azouzkm/CO2-Hyperventilation-monitor/docs/photos/README.md

# Bench photos

Named `YYYY-MM-DD_what.jpg`, resized to 1,200 px. The originals (HEIC) stay on the phone; HEIC is
not committed (`.gitignore`).

## 25 Oct 2026, session 3

| Photo | What it shows |
| --- | --- |
| `2026-10-25_coupon.jpg` | The tubing-fit coupon: five barbs, 4.8 to 6.4 mm, marked 1 to 5 dots |
| `2026-10-25_lid_and_coupon.jpg` | Lid and coupon side by side |
| `2026-10-25_flowcell_open_sensor_in_tray.jpg` | The MH-Z19C in the printed tray, cable out through the notch, lid beside it |
| `2026-10-25_flowcell_closed.jpg` | Flow-cell closed: inlet barb (next to the dot) and outlet barb on the lid |
| `2026-10-25_ring_soldered_to_grove_lead.jpg` | NeoPixel Ring 16 soldered to a Grove lead |
| `2026-10-25_shield_top.jpg` | Pico 2 W on the Grove shield, from above |
| `2026-10-25_button_and_speaker_leads.jpg` | Acknowledge button and speaker with their leads, before wiring |
| `2026-10-25_amplifier_front.jpg` | PAM8302A amplifier, front: bare holes, needs soldering |
| `2026-10-25_amplifier_back.jpg` | PAM8302A amplifier, back, with the hole labels |
| `2026-10-25_breadboard_button_and_speaker.jpg` | Button, speaker and resistor on the breadboard (no soldering) |
| `2026-10-25_shield_jumpers_gp18_gp20.jpg` | Jumpers to GP18 (speaker) and GP20 (button) on the shield |
