azouzkm/CO2-Hyperventilation-monitor/docs/photos/2026-10-25_amplifier_back.jpg

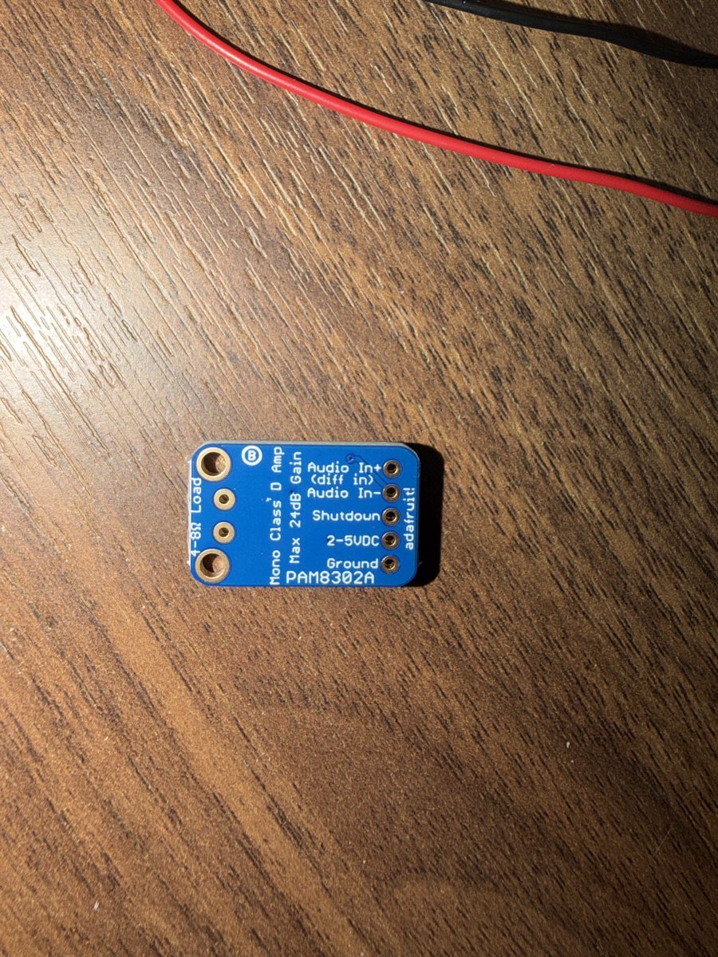
docs/photos/2026-10-25_amplifier_back.jpg
