azouzkm/CO2-Hyperventilation-monitor/docs/photos/2026-10-25_amplifier_front.jpg

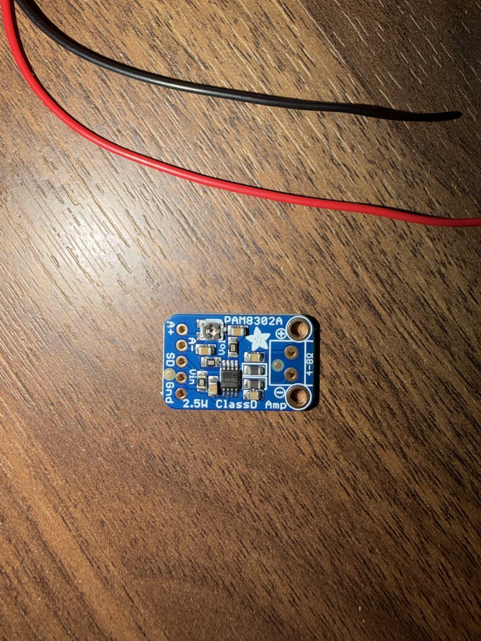
docs/photos/2026-10-25_amplifier_front.jpg
