azouzkm/CO2-Hyperventilation-monitor/docs/photos/2026-10-25_breadboard_button_and_speaker.jpg

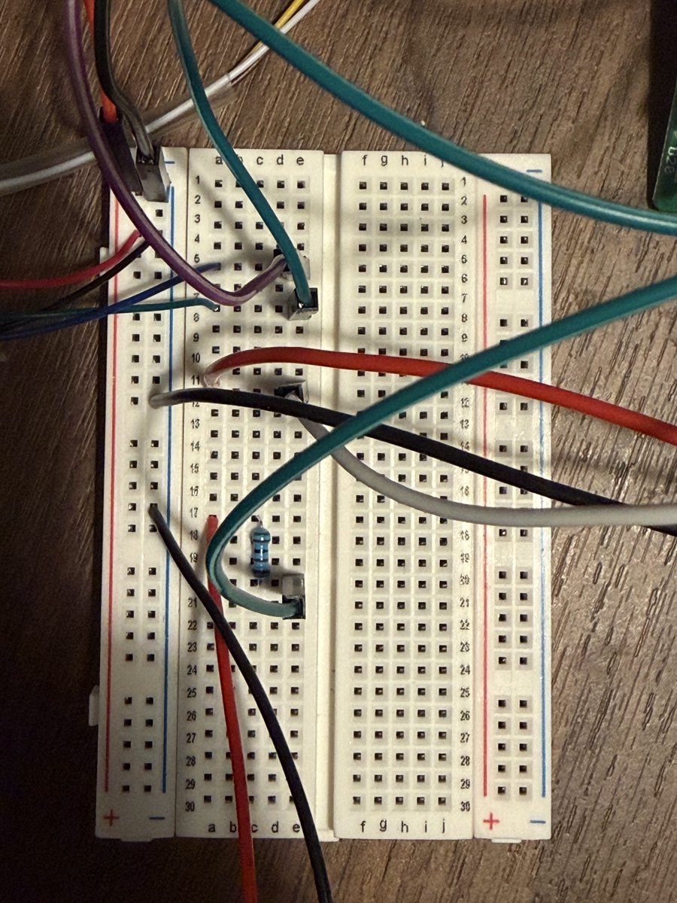
docs/photos/2026-10-25_breadboard_button_and_speaker.jpg
