azouzkm/CO2-Hyperventilation-monitor/docs/photos/2026-10-25_button_and_speaker_leads.jpg

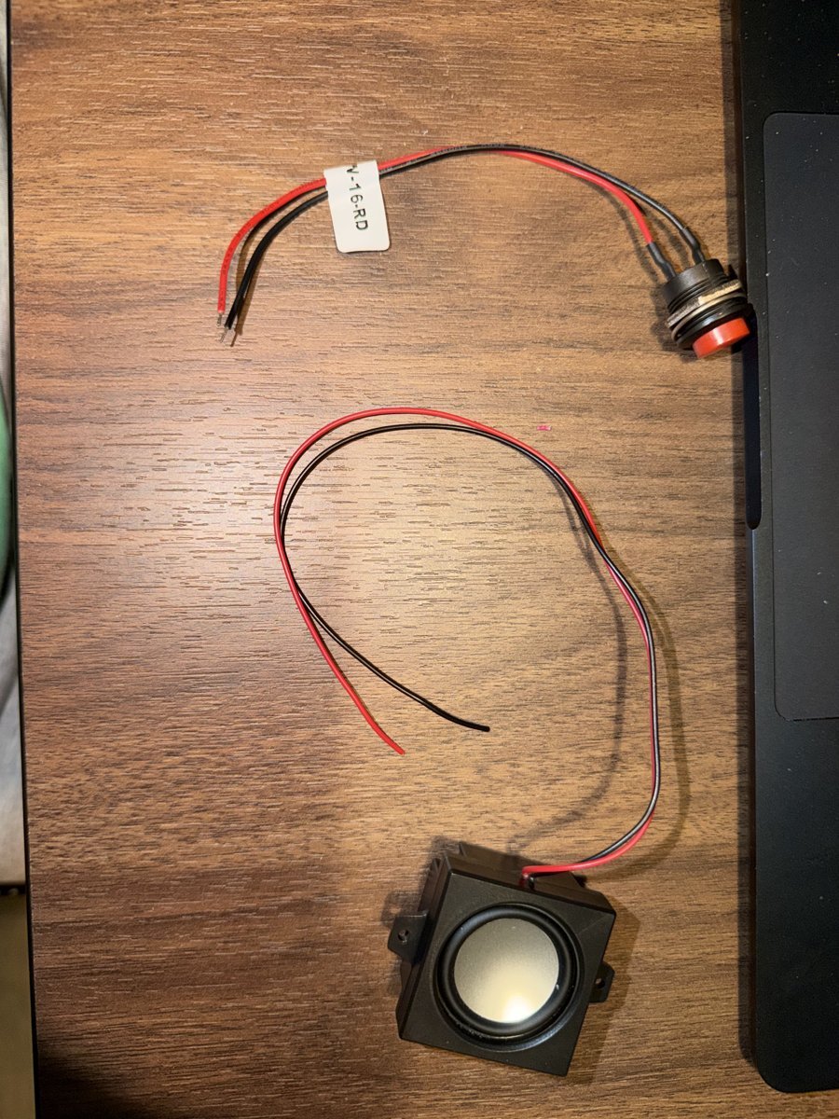
docs/photos/2026-10-25_button_and_speaker_leads.jpg
