azouzkm/CO2-Hyperventilation-monitor/docs/photos/2026-10-25_flowcell_closed.jpg

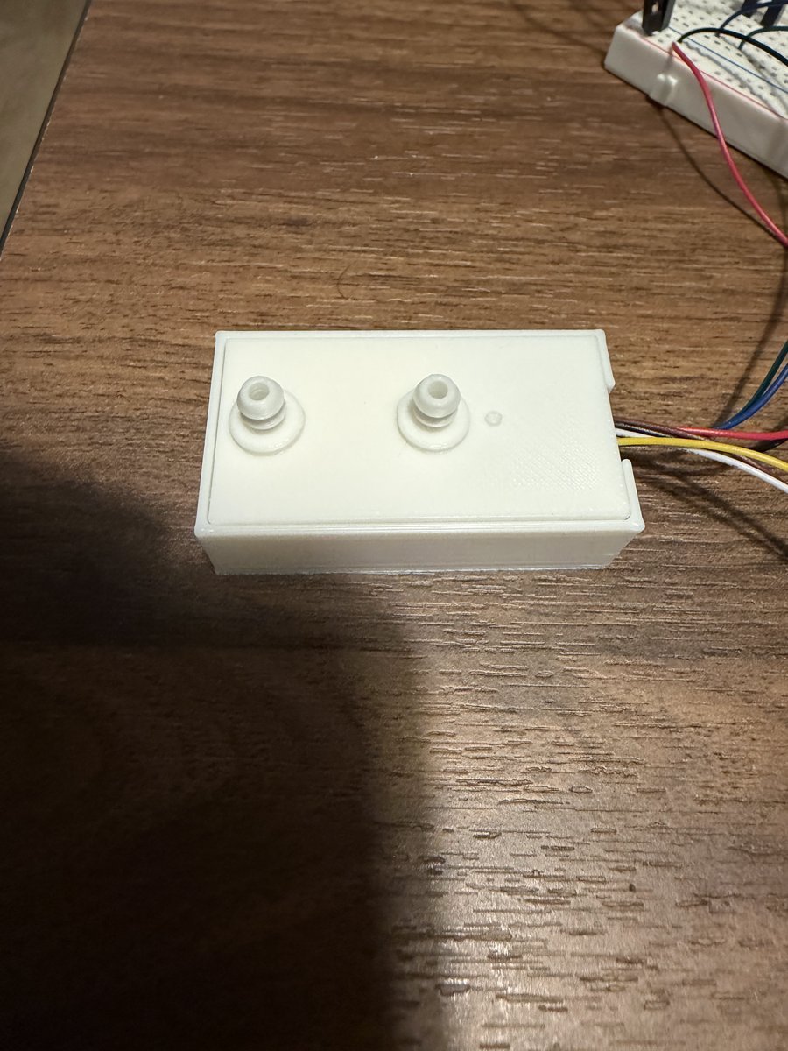
docs/photos/2026-10-25_flowcell_closed.jpg
