azouzkm/CO2-Hyperventilation-monitor/docs/photos/2026-10-25_flowcell_open_sensor_in_tray.jpg

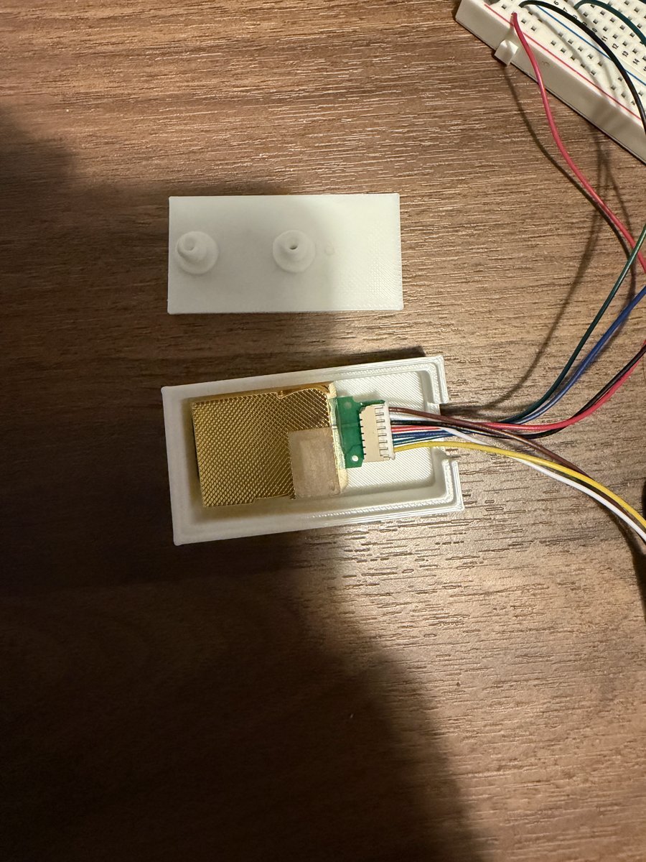
docs/photos/2026-10-25_flowcell_open_sensor_in_tray.jpg
