azouzkm/CO2-Hyperventilation-monitor/docs/photos/2026-10-25_lid_and_coupon.jpg

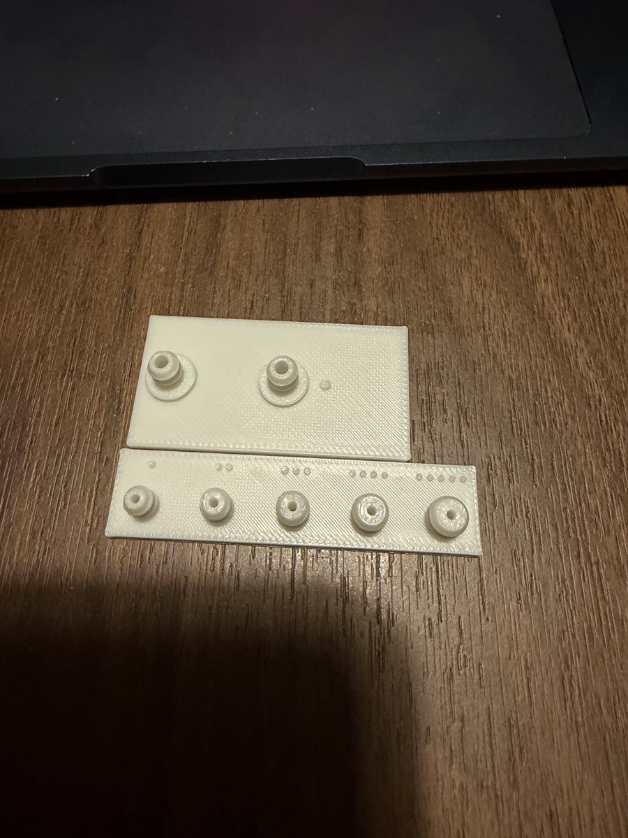
docs/photos/2026-10-25_lid_and_coupon.jpg
