azouzkm/CO2-Hyperventilation-monitor/docs/photos/2026-10-25_shield_jumpers_gp18_gp20.jpg

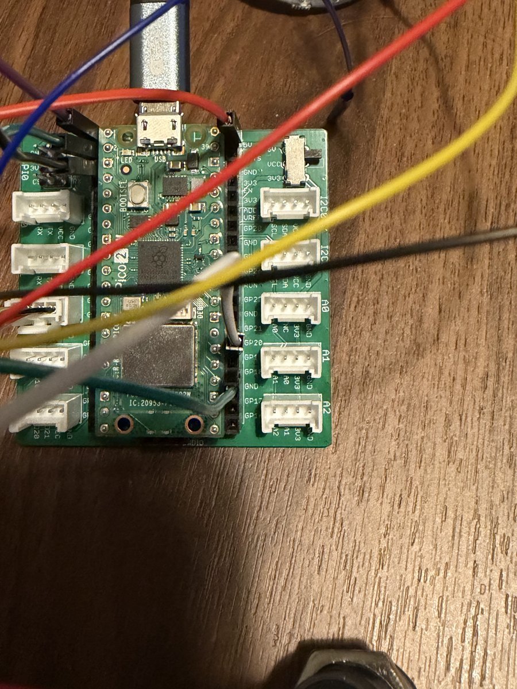
docs/photos/2026-10-25_shield_jumpers_gp18_gp20.jpg
