azouzkm/CO2-Hyperventilation-monitor/docs/photos/2026-10-25_shield_top.jpg

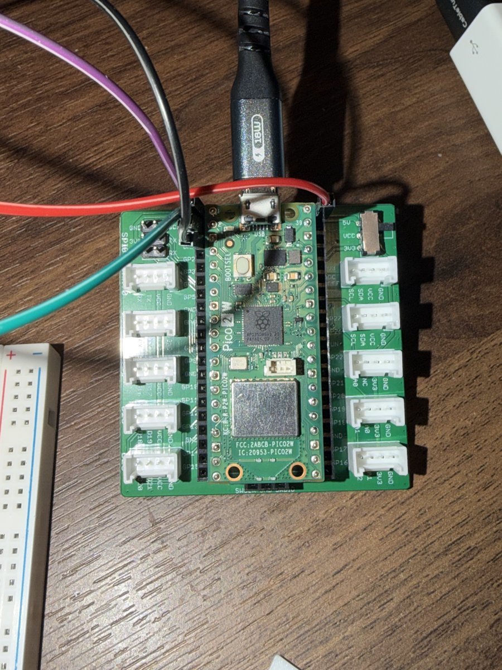
docs/photos/2026-10-25_shield_top.jpg
