azouzkm/CO2-Hyperventilation-monitor/hardware/cad/preview_v1_3d.png

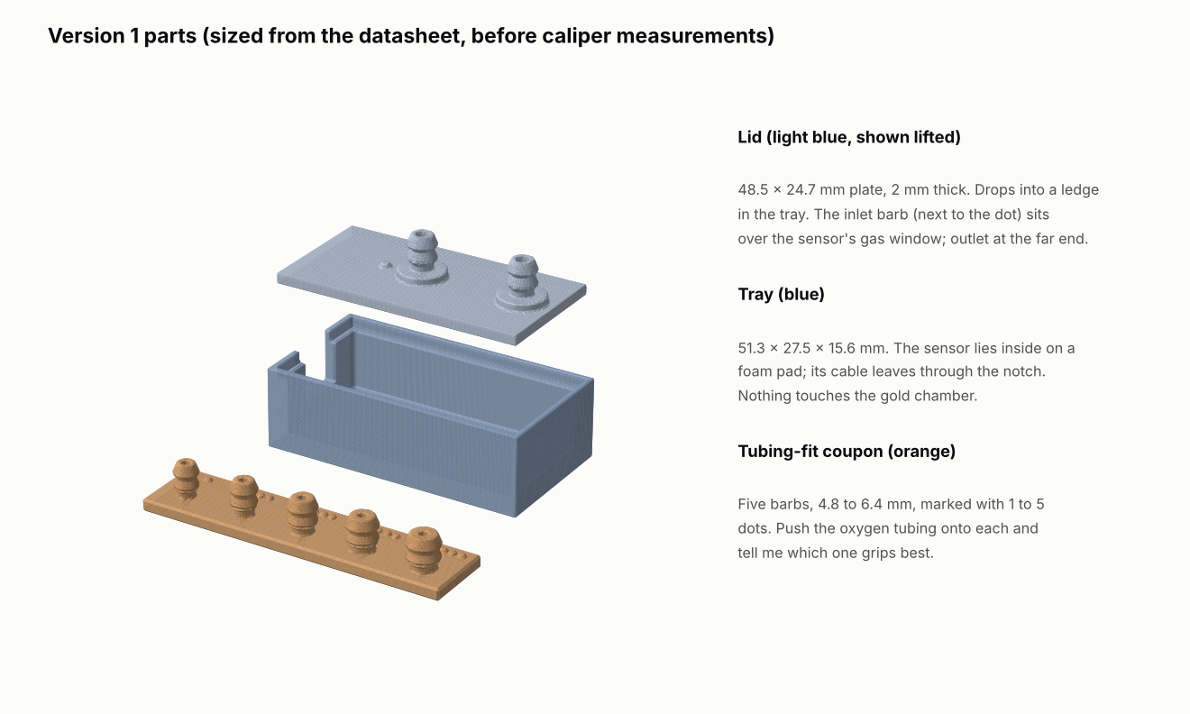
hardware/cad/preview_v1_3d.png
