azouzkm/CO2-Hyperventilation-monitor/hardware/cad/preview_v1_section.png

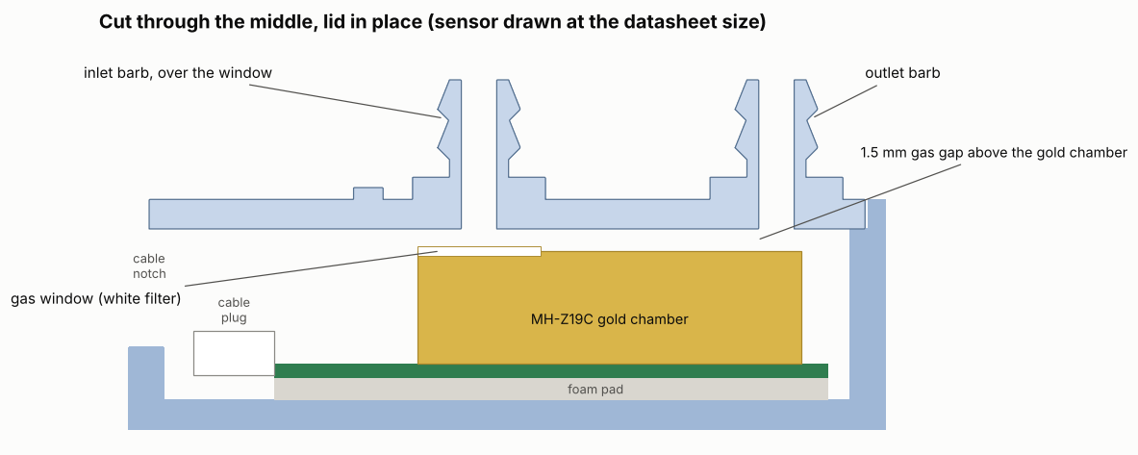
hardware/cad/preview_v1_section.png
