azouzkm/CO2-Hyperventilation-monitor/hardware/cr3_safety_clip_plug_and_socket.png

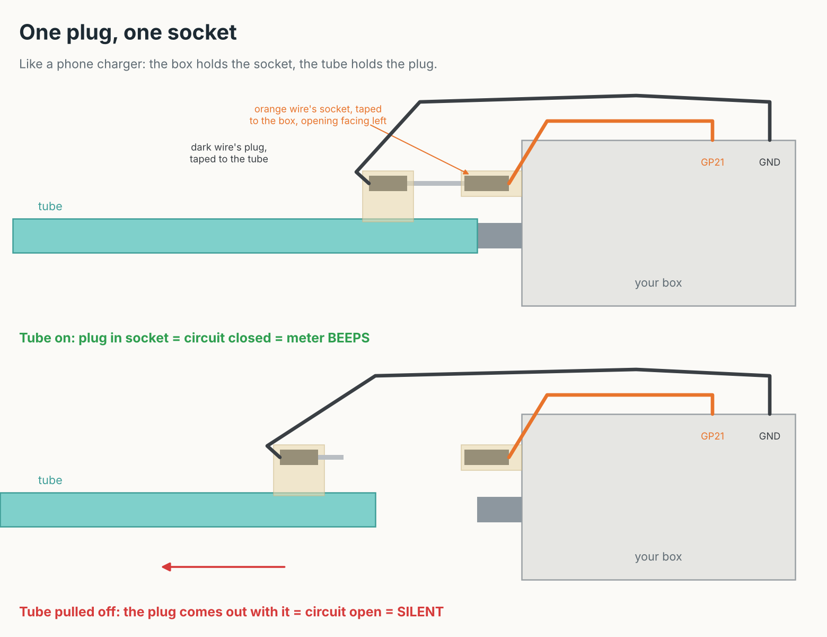
hardware/cr3_safety_clip_plug_and_socket.png
