azouzkm/CO2-Hyperventilation-monitor/hardware/ring_where_it_plugs.png

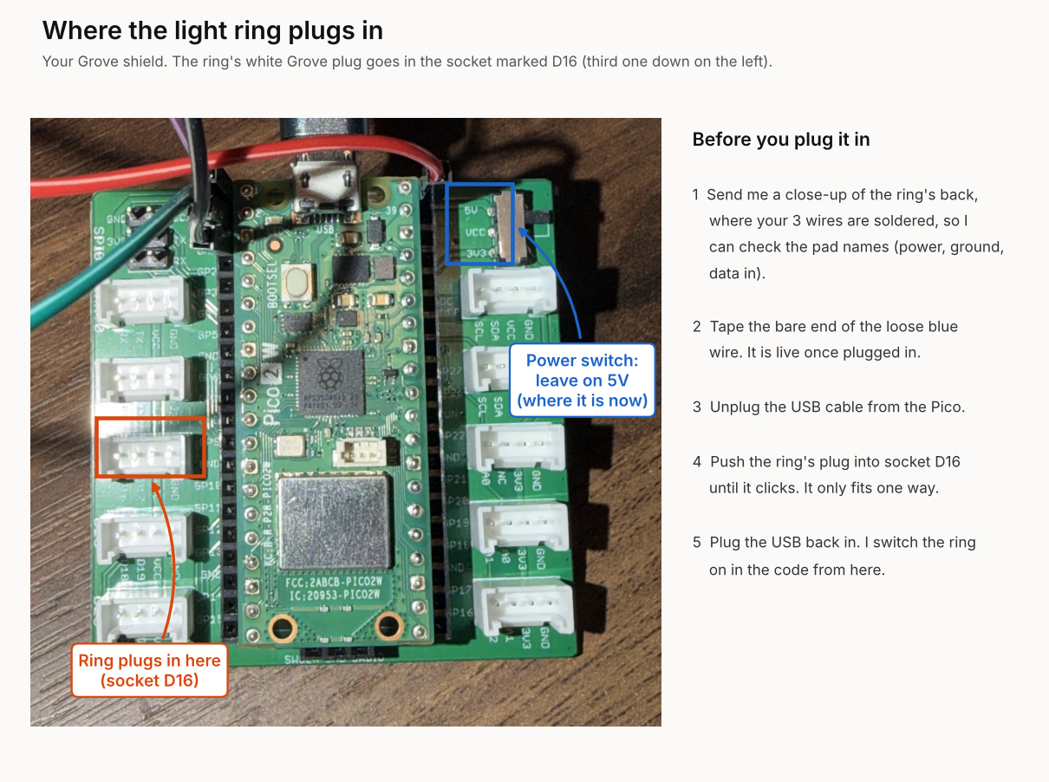
hardware/ring_where_it_plugs.png
