azouzkm/CO2-Hyperventilation-monitor/hardware/bill-of-materials.md

# Bill of materials

Kit as issued (EXSU 620 equipment sheet, P6: CO2). "Received" follows the ticks on the
sheet photographed on 2026-10-21. We use only parts from these two lists.

## Project-specific

| Qty | Part | Received | Use |
| --- | --- | --- | --- |
| 1 | NDIR CO2 sensor module: **Winsen MH-Z19C, 400–5000 ppm**, 7-wire terminal cable | Yes | The measurement |
| 1 | Mask, T-piece, sampling line and water trap | Yes | Bench gas path |
| 1 | Simulation lab capnograph | Borrowed later | Calibration and validation reference only |

## Standard kit (one per group)

| Qty | Part | Received | Use |
| --- | --- | --- | --- |
| 1 | Raspberry Pi Pico 2 W, headers pre-soldered | Yes | Controller |
| 1 | Grove Shield for Pi Pico v1.0 | Yes | Connectors and pin breakout |
| 2 | Grove to STEMMA QT / Qwiic cable | Have (not ticked) | Not needed for this UART sensor |
| 1 | Micro USB cable, 2 m, data capable | Yes | Power and data to laptop |
| 1 | Half-size breadboard and jumper set | Yes | Non-keyed wiring |
| 1 | NeoPixel Ring 16 with 40 mm frosted dome | Yes | Alarm light |
| 1 | PAM8302 amplifier with 3 W, 8 ohm speaker | Yes | Alarm tones |
| 1 | Acknowledge pushbutton, panel and mounting | Yes | Bedside acknowledge |
| 1 | Digital calipers | Yes | Printed-part dimensions |
| 1 | Pocket multimeter | Yes | Rails, continuity |
| 1 | Resistors, alligator clips, heat shrink, tape | Yes | Build and repair |
| 1 | Spare Raspberry Pi Pico 2 W | Not ticked | Backup board, confirm with instructor |
