azouzkm/CO2-Hyperventilation-monitor/hardware/cad/barb_fit_coupon_v1.step

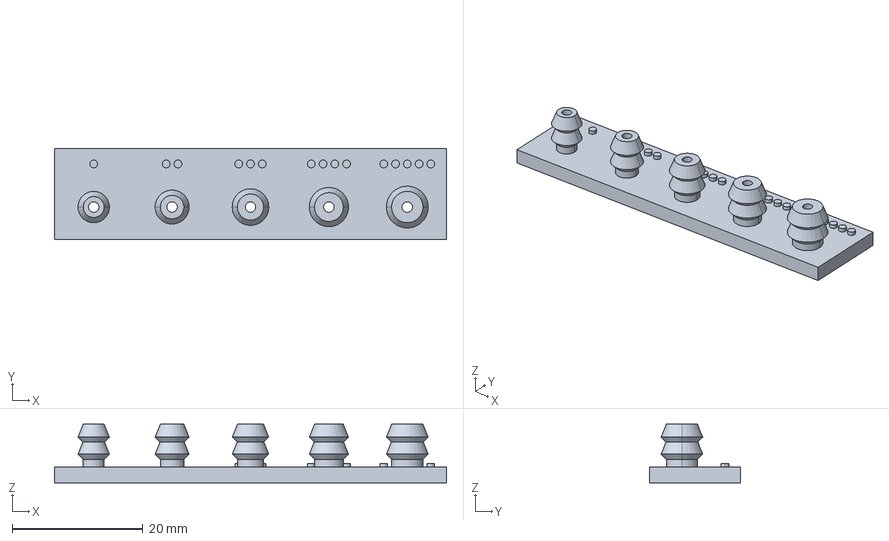
[picture p16: CAD file, 2026-10-23]
hardware/cad/barb_fit_coupon_v1.step
60.0 x 14.0 x 9.00 mm
