azouzkm/CO2-Hyperventilation-monitor/hardware/cad/flowcell_lid_v1.step

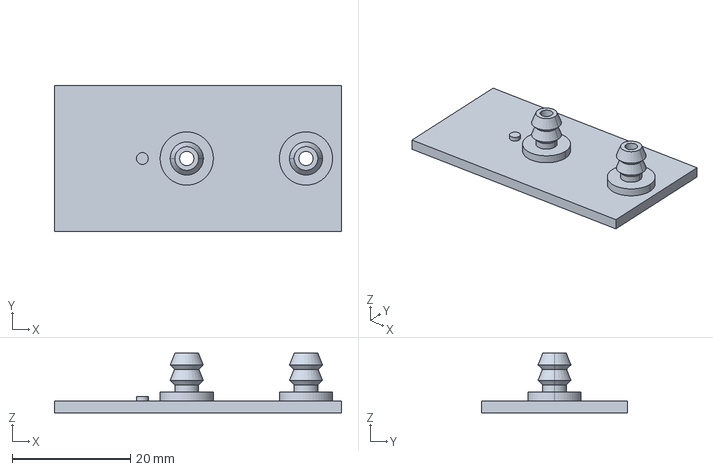
[picture p17: CAD file, 2026-10-23]
hardware/cad/flowcell_lid_v1.step
48.5 x 24.7 x 10.1 mm
