azouzkm/CO2-Hyperventilation-monitor/hardware/cad/flowcell_tray_v1.step

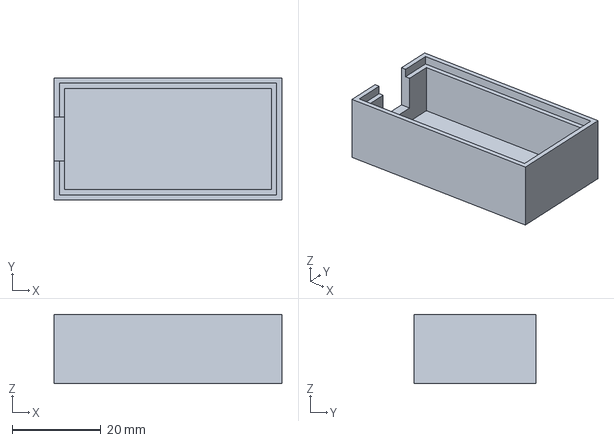
[picture p18: CAD file, 2026-10-23]
hardware/cad/flowcell_tray_v1.step
51.3 x 27.5 x 15.6 mm
