azouzkm/CO2-Hyperventilation-monitor/(list of files, cad)

Other CAD files:
hardware/cad/barb_fit_coupon_v1.stl
hardware/cad/flowcell_lid_v1.stl
hardware/cad/flowcell_tray_v1.stl
