azouzkm/CO2-Hyperventilation-monitor/docs/photos/2026-10-25_ring_soldered_to_grove_lead.jpg

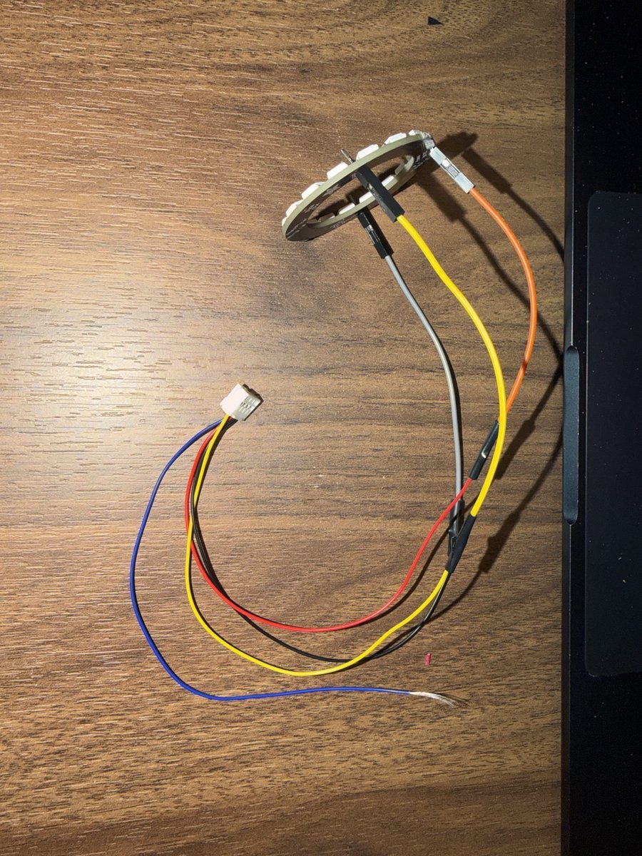
docs/photos/2026-10-25_ring_soldered_to_grove_lead.jpg
