azouzkm/CO2-Hyperventilation-monitor/hardware/button_speaker_wiring_no_solder.png

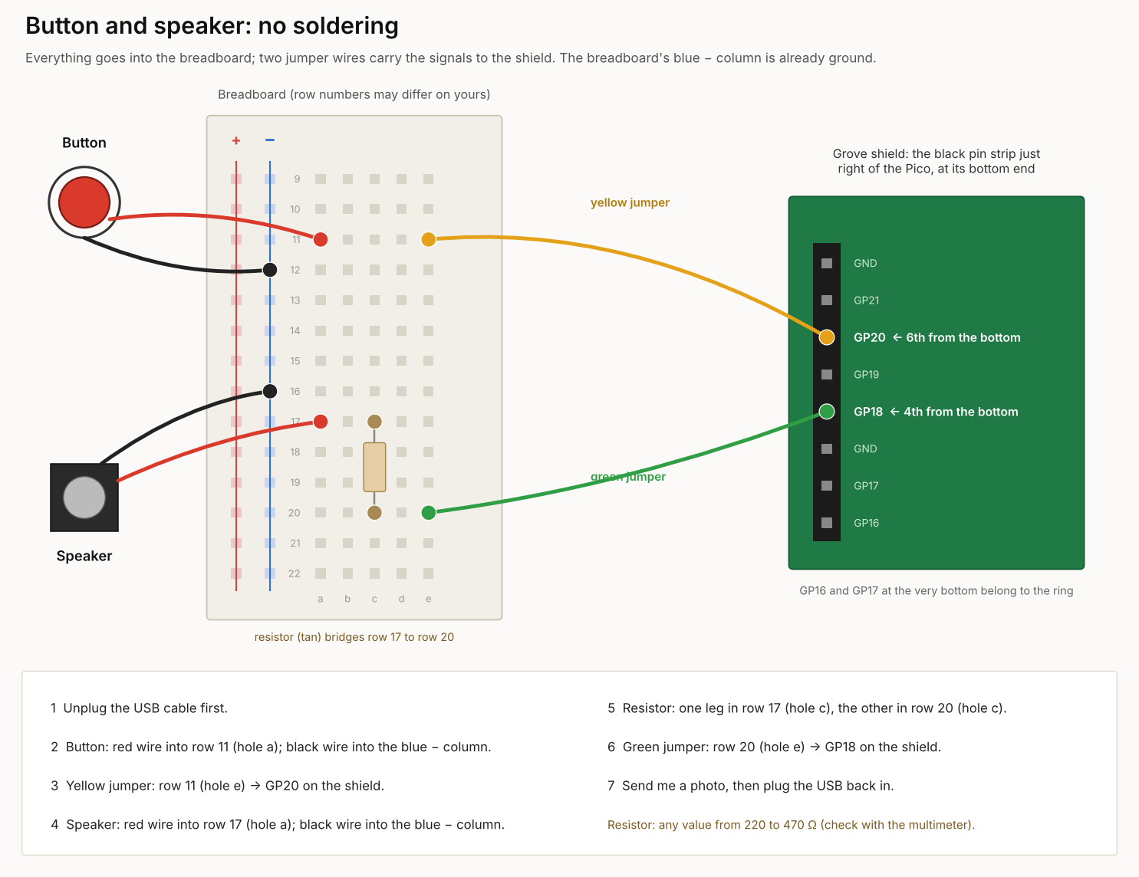
hardware/button_speaker_wiring_no_solder.png
