azouzkm/CO2-Hyperventilation-monitor/hardware/cad/flowcell_closing_steps.png

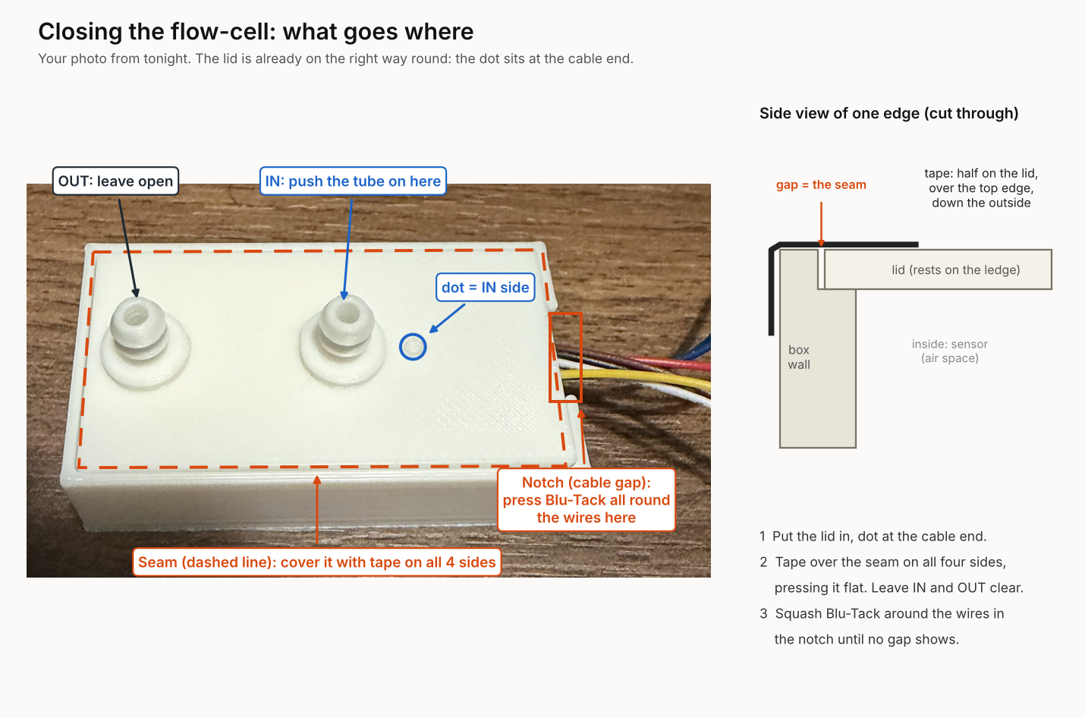
hardware/cad/flowcell_closing_steps.png
