azouzkm/CO2-Hyperventilation-monitor/hardware/cad/preview_v1_step.png

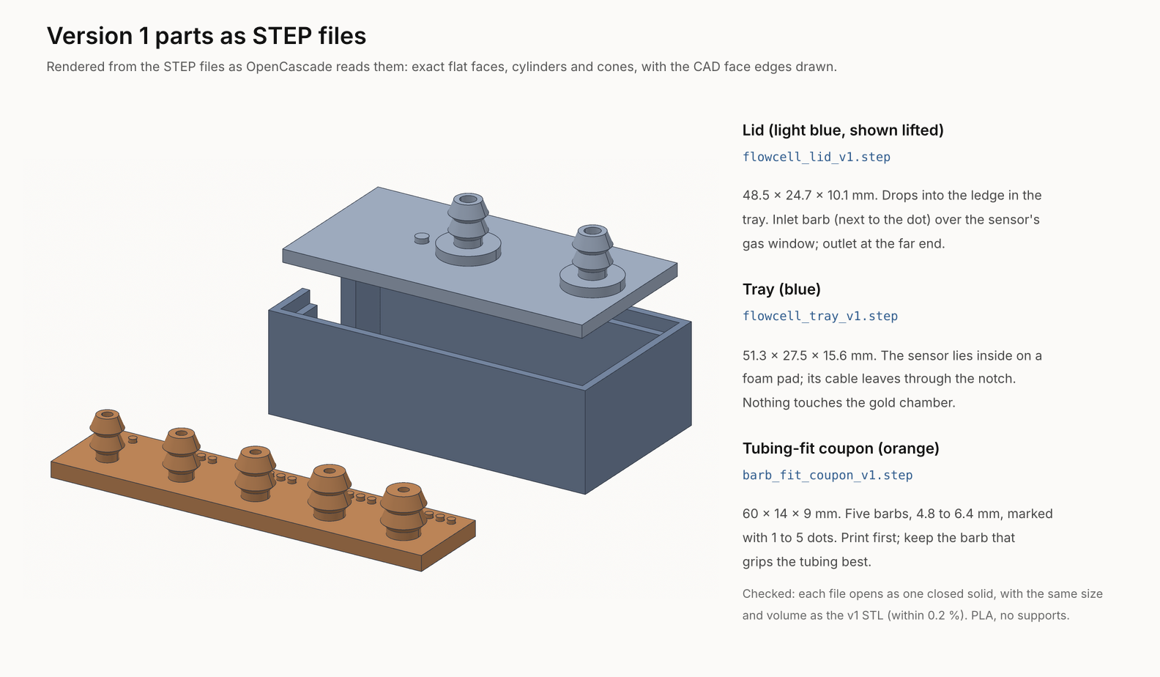
hardware/cad/preview_v1_step.png
