azouzkm/CO2-Hyperventilation-monitor/hardware/cad/PRINT_SHEET_v1.png

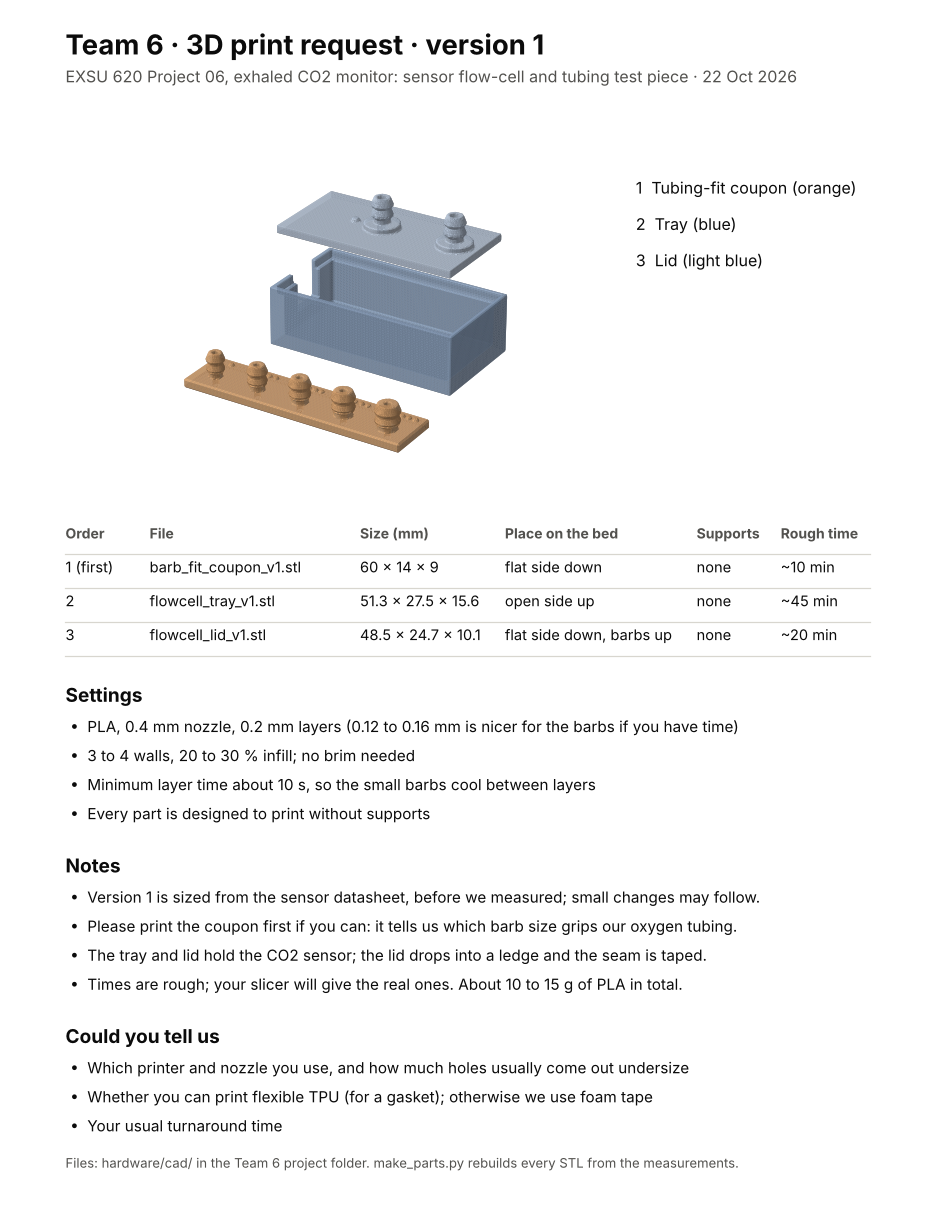
hardware/cad/PRINT_SHEET_v1.png
