azouzkm/CO2-Hyperventilation-monitor/hardware/cad/PRINT_SHEET_v1_step.png

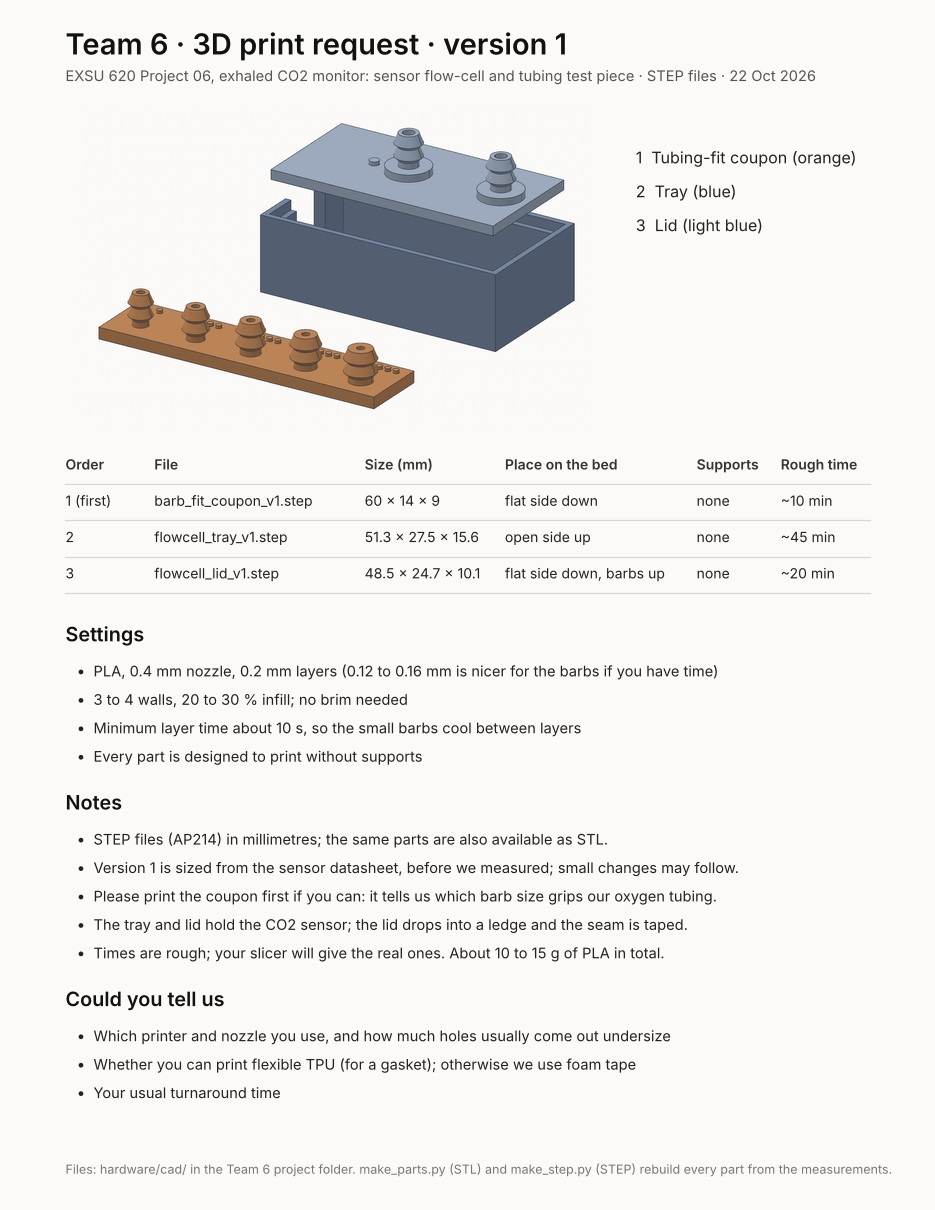
hardware/cad/PRINT_SHEET_v1_step.png
