azouzkm/CO2-Hyperventilation-monitor/hardware/cr3_step1_safety_clip.png

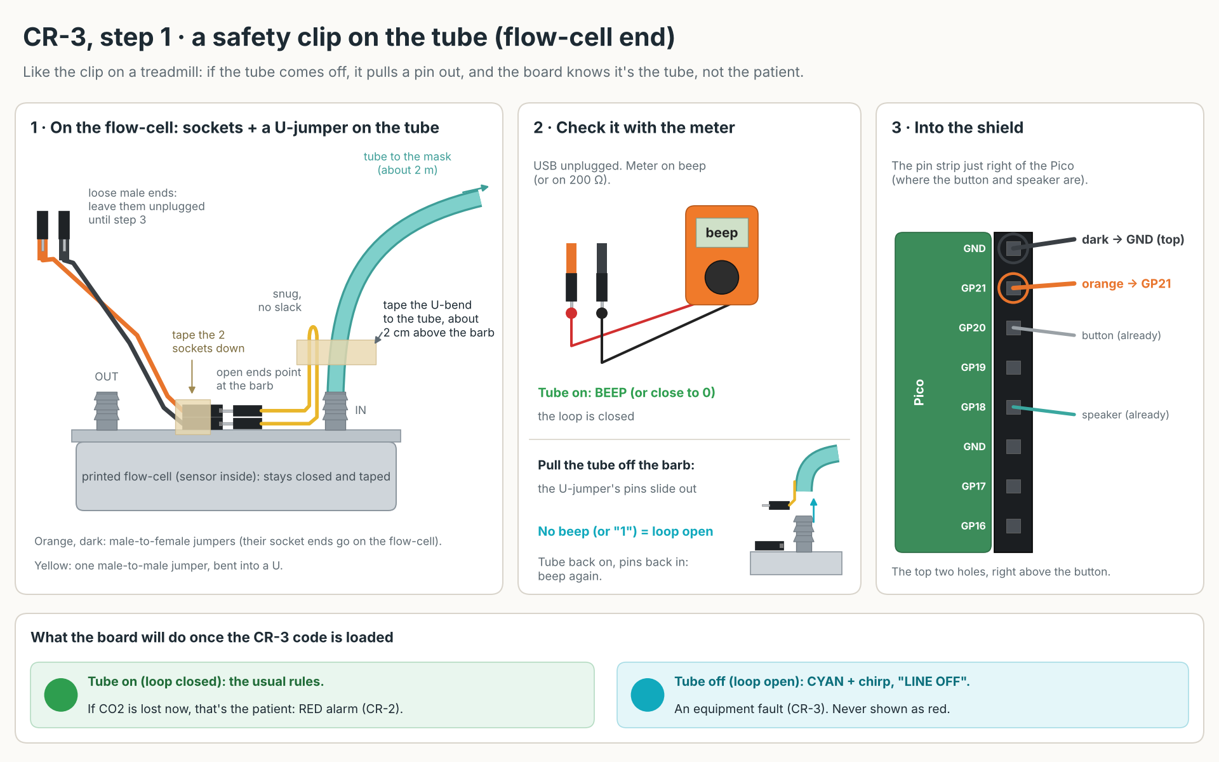
hardware/cr3_step1_safety_clip.png
