azouzkm/CO2-Hyperventilation-monitor/docs/figures/2026-10-22_breath-test-1.png

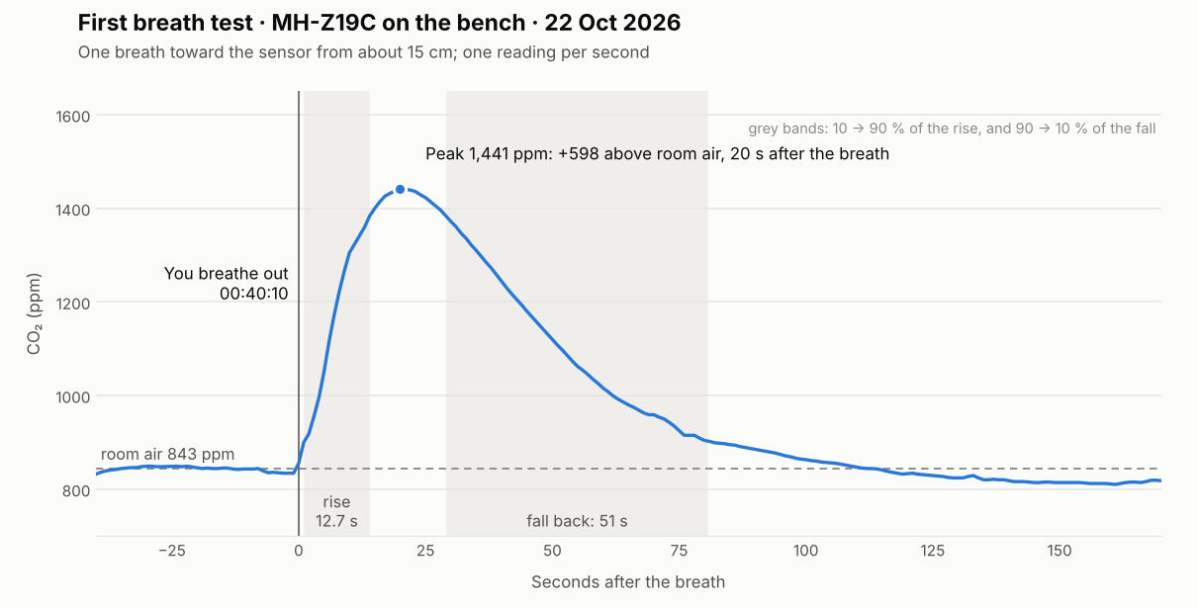
docs/figures/2026-10-22_breath-test-1.png
