azouzkm/CO2-Hyperventilation-monitor/docs/figures/2026-10-22_breath-tests-1-2.png

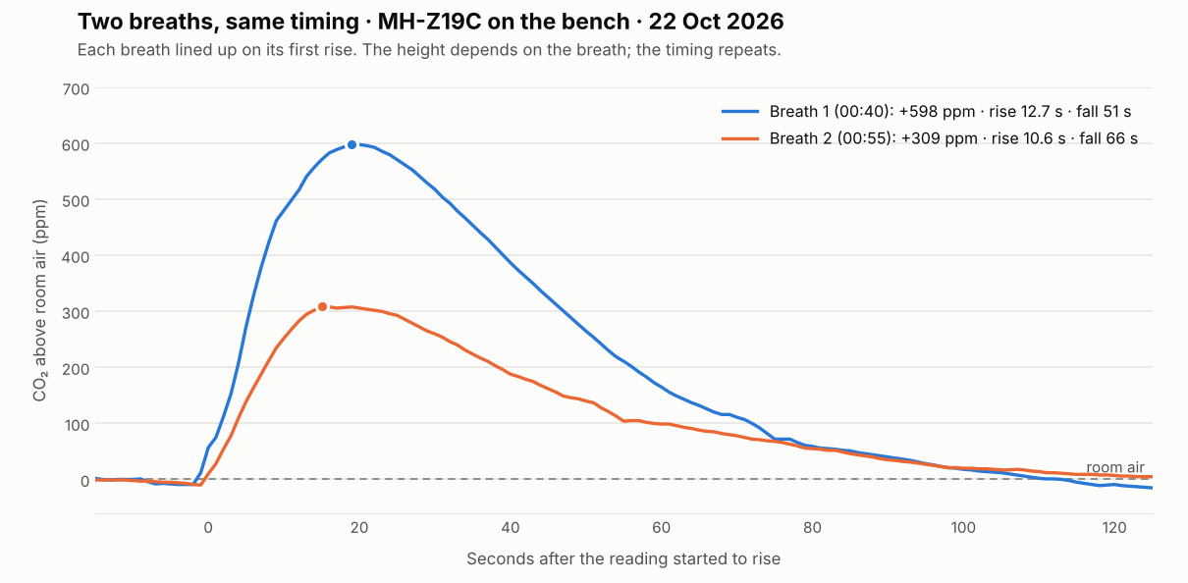
docs/figures/2026-10-22_breath-tests-1-2.png
