azouzkm/CO2-Hyperventilation-monitor/(commit log)

2026-10-21 Initial commit: Project 6 exhaled CO2 and hypoventilation monitor framework
2026-10-23 Bring the bench work into the team repo, with README, CONTRIBUTING and automatic tests
    [2026-10-22_session2_readings.csv, barb_fit_coupon_v1.step, barb_fit_coupon_v1.stl, flowcell_lid_v1.step, flowcell_lid_v1.stl, flowcell_tray_v1.step, flowcell_tray_v1.stl]
2026-10-25 Bench session 3: firmware v0.4 alarm, sensor-fault fixes, bench logs, print and soldering files
    [code.py]
2026-11-02 Session 4: firmware v0.6 (breathing rate, safety clip, saturation rule), dashboard and phone alerts, case build
